mirdej/dmxservos/hardware/dmx-servos.brd

## EAGLE design hardware/dmx-servos.brd (2016-08-17)

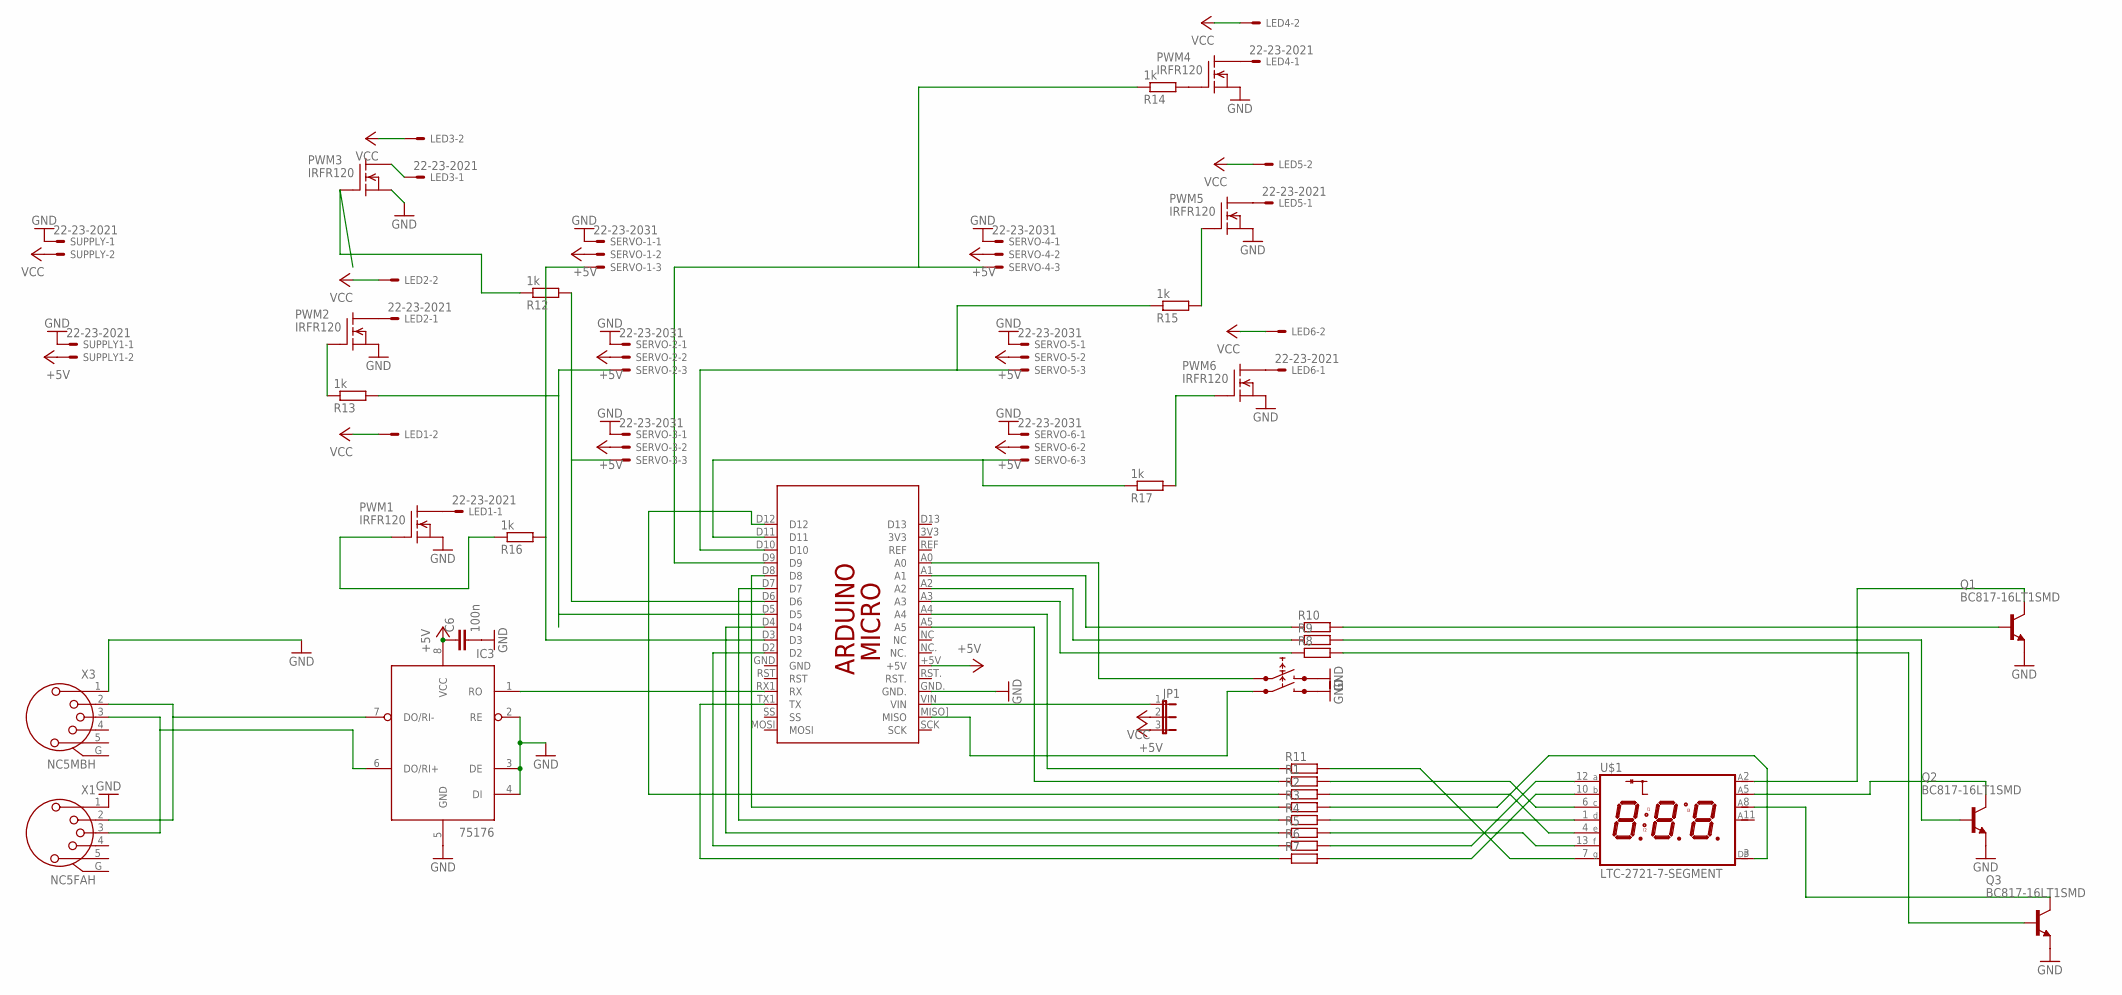
[picture p1: schematic dmx-servos.sch]

Parts:
C6: 100n; C0603
IC3: 75176; SO08
JP1: JP2E; JP2
LED1, LED2, LED3, LED4, LED5, LED6: 22-23-2021
PCB1: ARDUINO_MICRO
PWM1, PWM2, PWM3, PWM4, PWM5, PWM6: IRFR120; DPAK
Q1, Q2, Q3: BC817-16LT1SMD; SOT23-BEC
R1, R2, R3, R4, R5, R6, R7, R8, R9, R10, R11: R-EU_R1206; R1206
R12, R13, R14, R15, R16, R17: 1k; R1206
SERVO-1, SERVO-2, SERVO-3, SERVO-4, SERVO-5, SERVO-6: 22-23-2031
SUPPLY, SUPPLY1: 22-23-2021
U$1: LTC-2721-7-SEGMENT; LTC-2721
U$4, U$5: ALPS-TASTER-SKST
X1: NC5FAH
X3: NC5MBH

Connections:
+5V: C6.1, IC3.8 (VCC), JP1.3, PCB1.+5V, SERVO-1.2, SERVO-2.2, SERVO-3.2, SERVO-4.2, SERVO-5.2, SERVO-6.2, SUPPLY1.2
DMX2: IC3.7 (DO/RI-), X1.2, X3.2
DMX3: IC3.6 (DO/RI+), X1.3, X3.3
GND: C6.2, IC3.2 (RE), IC3.3 (DE), IC3.4 (DI), IC3.5 (GND), PCB1.GND., PWM1.3 (S), PWM2.3 (S), PWM3.3 (S), PWM4.3 (S), PWM5.3 (S), PWM6.3 (S), Q1.E, Q2.E, Q3.E, SERVO-1.1, SERVO-2.1, SERVO-3.1, SERVO-4.1, SERVO-5.1, SERVO-6.1, SUPPLY.1, SUPPLY1.1, U$4.P$2 (1), U$5.P$2 (1), X1.1, X3.1
unnamed: IC3.1 (RO), PCB1.RX1 (RX)
unnamed: PCB1.A0, U$5.P$1 (0)
unnamed: PCB1.D5, R13.2, SERVO-2.3
unnamed: PCB1.D3, R16.2, SERVO-1.3
unnamed: PCB1.D9, R14.1, SERVO-4.3
unnamed: PCB1.D10, R15.1, SERVO-5.3
unnamed: R7.2, U$1.10 (B)
unnamed: Q1.C, U$1.2 (D1)
unnamed: PCB1.D11, R17.1, SERVO-6.3
unnamed: PCB1.TX1 (TX), R7.1
unnamed: R6.2, U$1.12 (A)
unnamed: R5.2, U$1.13 (F)
unnamed: R4.2, U$1.1 (D)
unnamed: PCB1.D2, R6.1
unnamed: R2.2, U$1.4 (E)
unnamed: R1.2, U$1.6 (C)
unnamed: Q2.C, U$1.5 (D2)
unnamed: Q3.C, U$1.8 (D3)
unnamed: PCB1.D4, R5.1
unnamed: PCB1.D7, R4.1
unnamed: PCB1.D8, R3.1
unnamed: PCB1.D12, R2.1
unnamed: PCB1.A5, R1.1
unnamed: PCB1.A4, R11.1
unnamed: Q1.B, R10.2
unnamed: Q2.B, R9.2
unnamed: Q3.B, R8.2
unnamed: PCB1.A3, R8.1
unnamed: PCB1.A2, R9.1
unnamed: PCB1.A1, R10.1
unnamed: PCB1.MISO] (MISO), U$4.P$1 (0)
unnamed: PWM1.1 (G), R16.1
unnamed: LED1.1, PWM1.4 (D)
unnamed: LED2.1, PWM2.4 (D)
unnamed: JP1.1, PCB1.VIN
unnamed: LED3.1, PWM3.4 (D)
unnamed: LED4.1, PWM4.4 (D)
unnamed: LED5.1, PWM5.4 (D)
unnamed: LED6.1, PWM6.4 (D)
unnamed: PWM2.1 (G), R13.1
unnamed: PWM3.1 (G), R12.1
unnamed: PCB1.D6, R12.2, SERVO-3.3
unnamed: PWM5.1 (G), R15.2
unnamed: PWM6.1 (G), R17.2
unnamed: PWM4.1 (G), R14.2
unnamed: R3.2, U$1.3 (DP)
unnamed: R11.2, U$1.7 (G)
VCC: JP1.2, LED1.2, LED2.2, LED3.2, LED4.2, LED5.2, LED6.2, SUPPLY.2

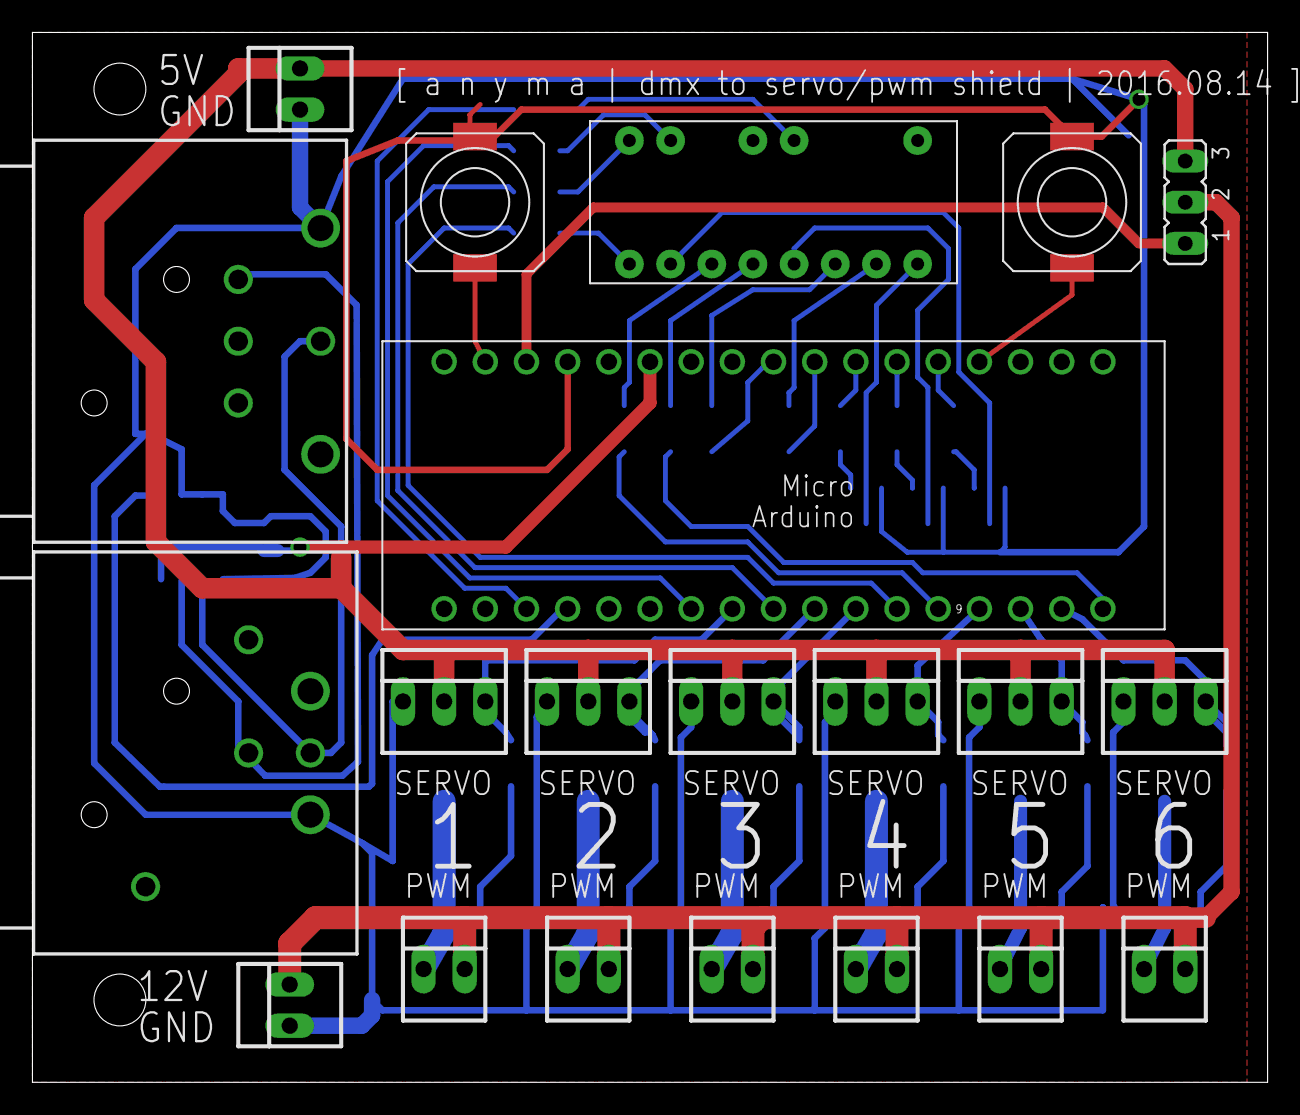
[picture p2: board dmx-servos.brd from above]

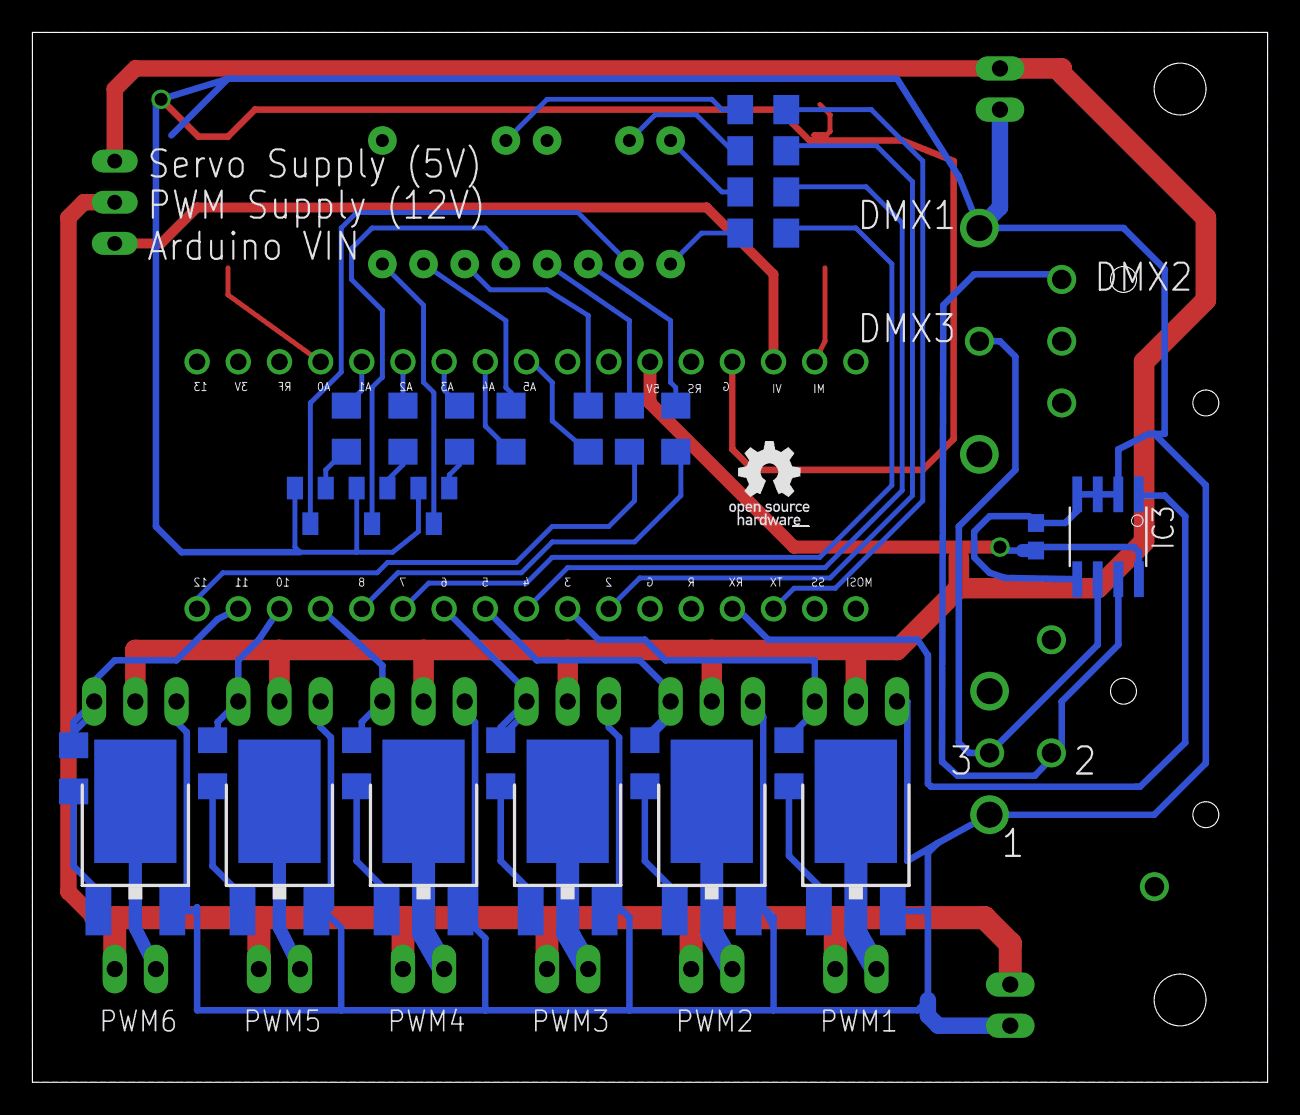
[picture p3: board dmx-servos.brd from below]

Board: 2 copper layers, 76.2 x 64.8 mm, 49 parts (28 on the bottom side), 52 nets.
