mirdej/dmxservos/(commit log)

2016-08-12 add board and schematic
    [dmx-servos.brd, dmx-servos.sch]
2016-08-12 servos and pwm working
2016-08-12 freed up D13 for dmx-ready display
    [dmx-servos.brd, dmx-servos.sch]
2016-08-17 in assignment in adjustable section
    [dmx-servos.brd, dmx-servos.sch]
